robwlakes/ArduinoWeatherOS/images/DualTrace.png

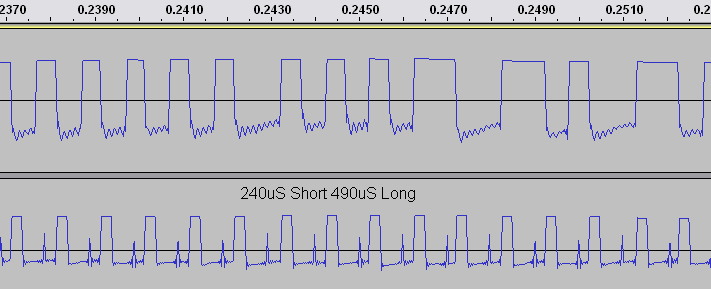
images/DualTrace.png
