robwlakes/ArduinoWeatherOS/(threads)

Thread 3 (2015-01-08):

Where is write CSV file ?

deennoo, 2015-01-08:
Hello Rob,

Nice Work You done !

I put your soft on my arduino, and a 433 recivere and my led on pin13.

I can saw my led blinking, and i think recieving my sensor information (i test osv3 sketch and it works).

Nowhere on your sketch i can see where is write the CSV file. please can you help ?

Thankyou

robwlakes, 2015-01-08:
Hi Deennoo,
The Arduino IDE has an icon in the top right hand corner that opens up a
"terminal" window to listens to the Arduino's output. I run mine at
115420 so you should set you Arduino IDE to the same Baud otherwise you
won't see much.
Also the last program that puts out the Wind, Temp and Rain on a CSV
string to the terminal (It does not write a file to the filing system as
such) waits until it has heard from all three sensors before it puts out
the CSV string to the terminal, so it may take a while, but usually
about a minute if they are close and signal is good.  If you watch the
Serial LED's (close to the Uno's pin13 LED) then you should see the
Serial Out flashing indicating that it is sending CSV strings of data
out the Uno's serial port.  It just depends on what is hooked up to that
serial port as to when, and how, those CSV style strings of characters
are seen (later processed, eg I use a Python program to listen to and
process the strings).

Just check your BAUD rate on your IDE, select the terminal window, and
wait maybe 2-3minutes at least before trying something else. I recommend
you get the simpler versions going first to just get a feel for how
everything works.  They start up straight away.

Good to hear from you,

*Rob Ward*
Lake Tyers Beach, 3909
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

deennoo, 2015-01-08:
OK i understand, first i'll wait to get some writting on serial monitor to be sure to recieve m'y sensor.

Can you share your python script ?  I want to update my Wu station with my sensor, with our exemple and anotherone (RTL_osv21) i think i'll get some succes

robwlakes, 2015-01-09:
I would be happy to but it is has been not prepared for distribution,
unlike my Arduino material.

I can certainly give you enough to get you going.

However let's get some good data off the Oregon sensors and Arduino first.

PS have you added the Air Pressure sensor and Humidity sensor?

*Rob Ward*
Lake Tyers Beach, 3909
Lake Tyers Beach Website <http://www.laketyersbeach.net.au>
XP to XUbuntu - The journey, join me!
<http://www.laketyersbeach.net.au/XP2XU.html>

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

deennoo, 2015-01-09:
Rob I dont had pressur And hum sensor on my arduino, m'y goal is to record log from all m'y osv3 sensor to update my WU station and my domoticz devices.For pressure i use a bthgn129 sensor who is osv2 And already add to RTL_osv21 by my selfEnvoyé depuis mon mobile Huawei-------- Message original --------Objet : Re: [ArduinoWeatherOS] Where is write CSV file ? (#3)De : Rob Ward À : robwlakes/ArduinoWeatherOS Cc : deennoo I would be happy to but it is has been not prepared for distribution,
unlike my Arduino material.

I can certainly give you enough to get you going.

However let's get some good data off the Oregon sensors and Arduino first.

PS have you added the Air Pressure sensor and Humidity sensor?

*Rob Ward*
Lake Tyers Beach, 3909
Lake Tyers Beach Website <http://www.laketyersbeach.net.au>
XP to XUbuntu - The journey, join me!
<http://www.laketyersbeach.net.au/XP2XU.html>

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

—Reply to this email directly or view it on GitHub.

robwlakes, 2015-01-09:
Not quite sure Deennoo what you are wanting to do.

My system at best just presents OS V3 sensors in human readable form, it
does not interface with  WWW weather services eg www.wunderground.com
etc though I am sure that could be written by people better skilled than
me.  However as it is now the software just does a simple, basic output
of data.

I am not sure what you mean here "WU station and my domoticz devices"
and "already add to RTL_osv21 by my self"

Pardon me for asking, I suspect English is not your native language?
This does not worry me, and I do not want to offend you, but I am not
fluent any other language, so if you have two languages you are doing
much better than me :-)

If you can give me a longer explanation of what you want to do I may be
able to help,

Best wishes...

*Rob Ward*
Lake Tyers Beach, 3909

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

robwlakes, 2015-01-09:
Hi Deennoo,

Sorry I have been reading and replying on email, and today I have looked on GIT-Hub for the conversation for the first time and seen all of your reply.
Your question about the "Does external sensor are needed to get value on serial monitor ?" was missing from the email.
Answer: In the last most complicated version of the program it uses two sensors connected to the Ardunio Uno board, however it does not wait for them to respond, it only waits until it has read all three wireless transmitters, Wind, Temperature and Rain.  If you don't have all three of these OS V3.0 sensors then it will wait for ever.
However the program usually crashes if the Pressure and Humidity sensors are not also there as it tries to read them and the library replies "Device not found" or some such warning.  I would suggest strongly to start from the simplest program and work your way up.  The simplest just prints out the raw codes coming in from the OS V3.0 wireless based sensors and does no processing on them (just the hexadecimal readings of the packet are shown) and does not refer to the Humidity or Pressure sensor at all so will not crash if you don't have them installed and also will not crash if you only have one OS sensor eg Rainfall.
Let me know if you can get some of the simpler versions working and how far you can get with them before things stop working.

Cheers, Rob

Here is the full circuit for the last program.
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
and it looks like this..
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

deennoo, 2015-01-10:
Rob,

what do you call simpler version ?

I got 3 .ino files
 - Debug_Auto
 - DebugManchester
 - Arduino_OsWeatherv26

What i want ? create a csv file who log my osv3 sensor

on Arduino_Osweatherv26
I try to remove BMP05 and DHT22 from your sketch, and update line 289 from 7 to 4 (by just keeping os sensor information) but result for the moment is still the same.

Does on serial monitor i can see some result of what your sketch recieve ?

robwlakes, 2015-01-10:
Sorry Deennoo,
Try the files here https://github.com/robwlakes/Weather-Station-OS-Sensors
These are my more up to date versions.
So try in this order:
DebugVersion12 Best Raw
DebugVersion12 BestDebugger

AlI apologise I did not realise you might have been in that repository. I hope you find these files more helpful.  The algorithm for Manchester decoding is so much better!

Cheers, Rob

deennoo, 2015-01-10:
ok thank you for last update, see you here !

Thread 4 (2017-02-10):

433Mhz Receiver

afeno, 2017-02-10:
Hello,
This is an excellent project and perfectly documented :)
I'm very excited to try to replicate what you have accomplished!
My main doubt is regarding the **433Mhz  Receiver board** that I should use. What 433Mhz Receiver board do you recommend?
I saw some basic and cheap boards but those looks different than the one that you have in the picture.
Example: https://www.aliexpress.com/item/Free-Shopping-433M-315M-2pair-4PCS-superregenerative-module-wireless-transmitter-module-RF-wireless-receiver-module/1850319332.html

Where can I buy the board that you used? Can you point me to some links on Aliexpress, DX, or eBay?

Thank you.
Best Regards,
Alfredo.

robwlakes, 2017-02-10:
Hi Alfredo,

I am very pleased you like the project.  I put a lot of work into the
documentation to "proof" it and try to discover and correct any errors
by doing so.  Plus a lot of other publications about Manchester encoding
and decoding were of very little help to my way of thinking.

You will find nearly any of those 433MHz Rx/Tx combinations will be ok
(as in your link).  Where the more expensive versions are better
includes-  they have a stronger rejection of noise (ie better filtered
out input), more stability, and also quicker Automatic Gain Control,
which stabilizes them onto the incoming digital modulation quicker.

Have a look at this one
http://www.ebay.com.au/itm/433Mhz-Superheterodyne-3400-RF-Transmitter-Receiver-kit-for-Arduino-ARM-MCU-/381196613735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

You will note that it does not have any coils or trimmer capacitors to
be seen which means the whole stability is in the chips on the board.

This is another brand, that is also a quality brand, Dorji,
https://wiltronics.com.au/product/7612/dorji-433mhz-107dbm-ask-receiver-dip-package/
If you are after a quality module then these Dorji receivers are
excellent if you want a better stability and more sensitive response.

The boards come in all shapes and sizes and are all pretty good, though
as I have outlined above, some are better than others.  If you intend to
use the system in a demanding environment eg noisy, long distance and/or
high temperature range (eg outside) then get a more expensive version.
My receiver is indoors and the transmitters are within 10m of the
transmitter, so the simpler cheap Rx works ok for me.  I made the board
up about 7 years ago before the better Rx's became more common. I would
choose a better Rx now if I needed to rebuild it.

I hope that helps,

Good luck and Cheers, Rob

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

--

*Rob Ward*
Lake Tyers Beach, 3909
Lake Tyers Beach Website <http://www.laketyersbeach.net.au>
Ubuntu Mate - A great OS <https://ubuntu-mate.org/>

afeno, 2017-02-11:
Thank you for the clarification and explanation about the differences between cheap and better receivers.
I bought the first one that you recommended because I can't find the Dorji's here in Spain.
I will keep you informed about my try to replicate what you did.
Thank you again for all your research and development!
Best Regards,
Alfredo.

Thread 5 (2017-02-12):

Rain calculation

Hserfontein, 2017-02-12:
Hi Rob,
I agree with afeno, this is an excellent project and perfectly documented :)
I would like to add my experience to your project. I did some vigorous testing on the rain calculation and found that a factor of "*25.4/1000.0" (instead of 25.0), yields a 100% accurate result compared to the Oregon base station.
The calculations should therefor read as follows:

void rain(){
  rainTotal = float(((nyb(18)*100000)+(nyb(17)*10000)+(nyb(16)*1000)+(nyb(15)*100)+(nyb(14)*10)+nyb(13))*25.4/1000.0);
  //Serial.println((nyb(18)*100000)+(nyb(17)*10000)+(nyb(16)*1000)+(nyb(15)*100)+(nyb(14)*10)+nyb(13),DEC);
  rainRate = float(((nyb(8)*10000)+(nyb(9)*1000)+(nyb(10)*100)+(nyb(11)*10)+nyb(12))*25.4/1000.0);
  //Serial.println((nyb(8)*10000)+(nyb(9)*1000)+(nyb(10)*100)+(nyb(11)*10)+nyb(12),DEC);

I am not sure, but I think it has to do with the fact that there are 25.4 mm in an inch.

Regards,
Hennie

robwlakes, 2017-02-12:
Thanks Hennie,

I am happy to add in your refinement.  I am about to add in the latest
version that also has the UV detector incorporated.  So I will update
the rainfall conversion factor at that time and give you due
acknowledgement.  The new version also incorporates an RGB LED that
signals with a colour as each sensor is successfully logged.  I don't
have the circuit diagram drawn yet to accompany it so it may be a little
while before the whole thing is updated.

I am pleased with your interest in the project and assistance,

Rob

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

--

*Rob Ward*
Lake Tyers Beach, 3909
Lake Tyers Beach Website <http://www.laketyersbeach.net.au>
Ubuntu Mate - A great OS <https://ubuntu-mate.org/>

Hserfontein, 2017-02-14:
Hi Rob,

I plan to add a hardware real time clock and SD card interface to mine to add a time stamp and store the data on the SD card, to make it standalone. I do not want to keep a computer running 24/7 just to record my weather data. Currently I am using CoolTerm to capture and store the data from the USB interface.

Looking forward to any new devlopments from your side.

Kind Regards

Hennie Serfontein (Snr)

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

Thread 6 (2017-03-20):

battery level

micg77, 2017-03-20:
Hello,
thanks a lot for your program.
I have found where the battery level is fixed : it is the 3rd bite of nyble 8.
If you add  battery_level = bitRead(nyb(8),2); you get it.

Hope it will help.

Micg77

robwlakes, 2017-03-20:
Hi Micg77,

Thank you for your interest in my work.  I spent a fair bit of time
trying to find a battery status bit, but could not confidently establish
anything I was confident in.  The very low current draw of these sensors
mean they approach the thermodynamic optimum to extract every last drop
from the battery (ie very little energy wasted as heat within the
battery due to its own internal resistance, which becomes more
significant the heavier the current).  As you will be aware I gave up
and devised a check on the consistency with the signals are received as
the indicator of battery health.  This also checks the actual state of
the sensor as well, ie has it fallen off the roof and lying at the
bottom of the garden???

You have also sent me another email regarding the negative bit on the
temperature sensor.  This one worries me more as people who are unlucky
enough to have to endure very cold temperatures maybe relying on that
data.  However I live in a climate that hardly ever reaches 2-3 degrees
Celsius let alone, negative Celsius.  We occasionally get frosts.  I
will definitely look into that myself.

You quote the model number of the Oregon Sensor for the thgr810
(humidity and temperature sensor using Oregon v3 protocol), was that the
one that you found the low battery bit as well?   I now have four
sensors stations: wind speed and direction, temperature and humidity,
rainfall, and have now added a UV sensor as well (3months ago).  I am
very occasionally getting some weird stuff from it though.  This morning
is an example.

SolarPower

Where you can see 5 hours ago (in total darkness) I have registered a
blip in UV Light.  I have used the standard OS checksum for the sensor
readings, so it must have complied with that to be recorded by the
Arduino.  Because I take the average of 16 readings, it is actually only
one rogue reading of 255, but this messes up the 16 subsequent readings,
hence 255/16=15, for 16 readings.  It can go for weeks before this
happens.  I am reluctant to write a crude filter, as I would prefer to
understand it and knock it out logically.  So for the moment I am
tolerating it.

If you happen to get a UV Sensor, then I would love to hear if you have
the same problem, or whether I have a faulty sensor.

Also when you were testing for the battery bit with the low temperature,
how did you eliminate the possibility that the battery low bit that
turned over did not come from erratic low voltage behaviour of the whole
system, rather than the sensor CPU deliberately switching that bit? I
found I could not be confident in the low battery indicators (that I
thought I had found) were not just random bits changing as the system
got closer to totally shut down.  Do you have an Oregon console that
receives and shows that low battery condition at the same time as you
can detect on the Arduino?  My console I keep in the kitchen does not
have any low battery indicators.  I feel that if Oregon had implemented
such a system their consoles would have shown the data on their LCDs.

Thank you for your interest and communication of your ideas.  As you can
see I retain an ongoing interest in this project and always keen to
improve it so I really appreciate your communication.  Have you
published your code anywhere?  I need to update my GitHub site very soon
so the UV stuff and LED activity indicators are revealed.

Cheers, Rob

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

--

*Rob Ward*
Lake Tyers Beach, 3909
Lake Tyers Beach Website <http://www.laketyersbeach.net.au>
Ubuntu Mate - A great OS <https://ubuntu-mate.org/>

micg77, 2017-03-21:
Hello,
thank you for your developed answer. (sorry for my level of english, I will do my best to answer you)
I don't have any UV sensor. so I can't help about your problem. But I have in mind to have one. So it is interesting for me anyway to have your feedback.

My project is not finished yet, so I haven't published anything. My goal is to control my electric heaters in each room of my house. So my arduino reads the temperature coming from 3 THGR810 sensors, and asked every electric heater to turn on or off depending on the instruction.
That is why it is important for me to have the low battery information;

I have done all my test with 3 THGR810 sensor. This kind sensor has a small screen. So i can read on it : temperature, humidity and low battery information.
So i can easily compare the screen with what tells the arduino.

I have also discover that the low battery sign turns on on the screen when the voltage is below 2,5 Volt.
To avoid rolling code problem, and minimise the number of changing value in the signal, I have build the following protocol : I have chosen 2 old AAA battery which have 2.53 Volt together at ambiant temperature (thanks to the toys of my kids). I have put the sensor in my freezer (minus -18°C) hoping that the old battery would have their voltage to decrease.
Then i have displayed all nyble waiting for any change and it has worked.
I have done many checks using this protocol.

To validate I have done some other tests with my other THGR810 sensor. And now I am really confident with my result.

Of course, I can't tell with the other kind of sensor (wind and rain).

Thanks again for your program which has helped me a lot to understand the oregon v3 protocol.

Cheers,

Micg77

robwlakes, 2017-03-21:
Hi,

My observation of the UV sensor is that it seems to reflect the "solar
power" of the day, and fluctuates largely in line with cloud cover.  So
while not being a direct solar power indicator could be used for home
control of solar heating features.  Eg opening or closing blinds etc  We
live by the sea at a popular but slightly remote beach front and people
getting exposure to UV (ie and later on cancer) is a problem so I
thought that sensor could help people be more careful.

THGR810 sensors is a good choice as think they have their station
numbers as switches?  So you can identify them.  Excellent choice.  I
have looked at those sensors in the shops but had not noticed the
battery level indicator.  I will check again for interest.  I tried to
do the low battery bit search on my anemometer as it the highest and
most dangerous to service (approx 8m high on top of steep roof).  I
could not determine any bit that changed predictably enough to be
confident of its status.  It would be good to focus though on that bit
you have identified and recheck it all over again.  I have a spare
anemometer as a backup, so I could experiment with it.  I really like
the idea of putting the batteries in the freezer to help accentuate the
"failing" battery voltages.  Excellent work!!

Replicating the same bit across three sensors is also excellent
science.  I like what you do.

I will take my anemometer to my son's place next time and experiment for
the battery bit. (Ignoring the rolling ID codes means I can't use it at
our home or it will confuse the Weather station Arduino.)  You have
inspired me to give it one more try.

Thank you, Micg77.

Rob

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

--

*Rob Ward*
Lake Tyers Beach, 3909
Lake Tyers Beach Website <http://www.laketyersbeach.net.au>
Ubuntu Mate - A great OS <https://ubuntu-mate.org/>

Thread 7 (2017-03-20):

negative temperature - THGR810

micg77, 2017-03-20:
Hello,

I've done some test with thgr810 (humidity and temperature sensor using oregon v3 protocol) that i've put in my freezer (in order to reach the low battery level).
With this sensor the nyb(12) is changed at 8 and not 1 when temperature goes below 0.
may be it depends on the kind of sensor.
Best regards,
Micg77

Saphareas, 2017-12-08:
How did you even get this working? I get nothing with this Sensor (only one I've tested).

robwlakes, 2018-01-13:
Did you get yours working? I have added Darko's code for decoding negative temperature. I don't live in a climate where outside temperature drops below zero (all year), so I was not alerted myself to this problem.

Thread 8 (2020-06-08):

Anenometer only

pdbayes, 2020-06-08:
Hi

Excellent well documented project. I only have the anenometer and want to capture the data from that. I cannot seem to get any serial data from it using your code except for the initial output. Were would I need to remove code to only collect data from the anenometer.

Thanks

Paul

robwlakes, 2020-06-11:
H i Paul,

Apologies for the delay in answering this. I am going to assume you are
trying to use ArduinoWeatherOS
<https://github.com/robwlakes/ArduinoWeatherOS>. It is set up to use
multiple sensors and and to block any reporting until all the sensors
have been "heard" and sensible data collected from them. If you are only
after the wind data you will be able to cut a lot out of the program.
Check the lines in Red here, they do the blocking until all 3 main
sensors have been heard.

   // Stn Id, Packet Type, Wind Quadrant, Wind Speed, Rain Tips, Ext
temp, Int Temp, Int Pressure, Int Humidity
   intHumi = (double)dht.readHumidity();      //DHT22 readings %Humidity
   intTemp = (double)bmp.readTemperature();   //internal temperature
   intPres = (double)bmp.readPressure() / 100.0; //Pa reduced to mBar
*//leave this check at 7 until the other readings are stabilized**
**  if ((scan&7)==7) {               //scan==15 means all 4 readings now
have a valid value, ready for output on Serial**
*    //Battery/Signal status, OR in the the four status values for the
signal connections.
     logTemp++;
     if (logTemp>40){
       batStat = batStat | 1;
       }
     logWind++;
     if (logWind>40){
       batStat = batStat | 2;
       }
     logRain++;
     if (logRain>40){
       batStat = batStat | 4;
       }
     logUV++;
     if (logUV>40){
       batStat = batStat | 8;
       }
     logExp++;
     if (logExp>40){
       batStat = batStat | 16;
       }
     //reset the batStat to 0 every 24hours
     aday++;
     if (aday>1440){
       batStat=0;
       aday=0;
       }
     // Order: Battery Status, Quadrant, Wind Gust, Rainfall,
Temperature, InternalTemp, Internal Pressure, Int Humidity, Solar Power,
Lightning, UV Radiation
     Serial.print(batStat,DEC);       //Send out the number to indicate
if a sensor is not transmitting for maore than 20 mins. Low Battery or
other damage.
     Serial.print(",");
     Serial.print(quadrant);          //0-15 in 22.5 degrees steps clockwise
     Serial.print(",");
     Serial.print(gustWindspeed, 1);  //Gust windspeed km/hr, not
average windspeed (graphing over 10 samples gives Average)
     Serial.print(",");
     gustWindspeed = avWindspeed;     //reset gust to average, then take
the larger next reading
     Serial.print(rainTotal, 1);      //currently considered to checked
for a good calibration to mm
     Serial.print(",");
     Serial.print(temperature, 2);    // OS Temperature Centigrade
     Serial.print(",");
     Serial.print(intTemp, 2);        //BMP085 temperature (used for
compensation reading) Centigrade
     Serial.print(",");
     Serial.print(intPres, 2);        //BMP085 pressure reading milli-bars
     Serial.print(",");
     Serial.print(intHumi);           //Digital DHT22 seems better than
the OS in Temp/Hum sensor % relative
     Serial.print(",");
     Serial.print(intSolar,DEC);       //A reading from experimental
Solar Power sensor
     Serial.print(",");
     Serial.print(intLightning,DEC);       //A reading from the nos of
Lightning Strikes
     Serial.print(",");
     Serial.print(intUV, DEC);      //UV Sensor
     Serial.println();

     //Indicate the transmission of this one second data with a white
light set up R+B+G!!
     digitalWrite(RedPin, 0);         //White, all colours on, data has
been logged to the Server
     digitalWrite(GrePin, 0);
     digitalWrite(BluPin, 0);
*}*
}

If you remove that IF clause then it should at least begin reporting
your wind data and just the initialising defaults for the other sensors.

Once you have that working you can owrk backwards to trim the program
back to what you need for your project.

Thank you for taking an interest in my project and communicating with me
about it.

Best wishes,

Rob

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
--

*Rob Ward*
Lake Tyers Beach, 3909
Lake Tyers Beach Website <http://www.laketyersbeach.net.au>
Ubuntu Mate - A great OS <https://ubuntu-mate.org/>

pdbayes, 2020-06-12:
Hi Rob

Thanks for getting back to me. I tried removing the If statement but I am
not having much success. I put in a load of debugging and thought I could
see 5 byte packets from the anemometer, but nothing ever gets analysed and
output.
I am now running your auto debug code to see what I get. I'll share a dump
of the output later to see if you can make any sense of it.
I am using an Arduino uno and an RXB6 receiver.
Thanks again for all the work you have put in to this.

Paul

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

pdbayes, 2020-06-12:
i think I also have an issue that we have 433mhz oil tank level sensors. If
the signal from them is strong then the AGC is doing to crank down the
sensitivity and miss the Oregon bursts. Not sure how to deal with that.

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

robwlakes, 2020-06-12:
The wind sensor repeats about every 14 seconds, so it should be able to get at least one burst in every now and then.

Are you sure your receiver is wired up ok? If you put an LED + 220ohm resistor on the Tx output, and press reset on the wind sensor it should show z distinct burst of signal on the Rx straight away. Quite a few people who gave contacted me have found their Rx is the fault. I looked up your Rx and it looks very good quality. Maybe even your antenna needs checking, a simple whip of 170mm hook up wire is ok, especially at small distances.

Legally 433Mhz signals should only broadcast intermittent bursts. So the tank system should not swamp your Rx continually.

Rob

Cheers, RobW

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

pdbayes, 2020-06-12:
Thanks again

I'm sure it is recieving data from somewhere as I do get consistent 5byte
blobs of data. I have found the info for decoding the depth sensor so I can
see if I am picking that up. Might be useful to have anyway. I get an I'd
of 1985 a lot. I thought the anenometer was either 1995 or 1994?

I can send a dump from the debug if you have time to take a look.

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

Thread 9 (2020-08-28):

WGR800 error - wind speeds >10m/s

jrhilton, 2020-08-28:
Hi, I've noted that wind speed never goes above 36km/h (10m/s) yet when I look on the OS consol during high winds it does.

The speeds match up exactly to the consol otherwise, except during very high winds. What could be causing this issue?

Almost as if it should be something like this to also get the tens, as I can see it gets the ones, and decimal tenths:
`double gust = (**(nyb(14) * 100) +** (nyb(13) * 10) + nyb(12)) * 3.6 / 10;`

and
`avWindspeed = (**(nyb(17) * 100) +** (nyb(16) * 10) + nyb(15)) * 3.6 / 10;`

Not had a chance to upload this to try, but has anyone else noticed this issue?

robwlakes, 2020-08-29:
Now that is very interesting James, I have had similar suspicions. Not
the least of which occurred this last Thursday night when there was big
wind storms across the state and we copped a bit of it too. It felt like
it was about to take the solar panels off the roof. Yet the wind speed
30+ something did not seem to reflect the feeling I had that it was
exceptional. I will check the code I am using at the moment and try your
suggestion.  I have wanted to update this code for ages but GITHub I
find incredibly frustrating and not for beginners like me. I seems to
tie myself in knots just to get an update to work (entirely due to my
ignorance I am sure).

Thank you for interest and analytical thinking about this. I will get
back to you.

Rob

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
--

*Rob Ward*
Lake Tyers Beach, 3909
Lake Tyers Beach Website <http://www.laketyersbeach.net.au>
Ubuntu Mate - A great OS <https://ubuntu-mate.org/>

jrhilton, 2020-08-29:
Hi Rob, many thanks for your reply. I've had another read of [http://wmrx00.sourceforge.net/Arduino/OregonScientific-RF-Protocols.pdf](this) document that details the RF Protocols and it does spec three nibbles making up the speeds, so adds some substance to my logic. The numbering of the nibbles is slightly offset in that document vs your code, but if you normalise them using the wind direction nibbles then there is a perfect overlap when you add in nyb(14) and nyb(17) to your code.

I've now added this code:

`gustActualMS_tst = ((nyb(14) * 100) +(nyb(13) * 10) + nyb(12)); //new test
avWindspeedMS_tst = ((nyb(17) * 100) + (nyb(16) * 10) + nyb(15));//new test`

Which are also sent via the serial port using dumpAnemom() and logged. I may need someone else to help validate this too as wind speeds >10m/s are rare here in London, UK. So it maybe many months before I get some actual data to validate it myself, but I will be sure to report back when I do have some data.

Stay safe and well in these times!

robwlakes, 2020-08-30:
Hi David,

I ignored my own notes from about 10 lines up. Thank you for your
diligence, I have altered the source code and hope to update it on
GITHub ASAP. I have added an acknowledgment for your contribution.

Like you, we don't often experience over 36m/s winds, even though we are
on the southern east coast of mainland Australia. We are only 10minutes
walk form the ocean. However we are at the top of a very wide bay and
don't really get the feel of the roaring fourties. So it maybe a while
before we can see any difference. I have an updated version of the
Manchester algorithm that I will incorporate when I update. It is much
more elegant than in the current version. Same concept but not as
convoluted.

I think what we would have seen with the MSB missing would have been
chopped wind speeds reported when the reading was above 36km, LSB's 
would have dropped to "low" and the MSB would have been absent to take
over. I feel I have noticed that before and just put it down to gusty
conditions, ie peaks and troughs. Whereas it could have been hovering
above and below 36m/s consistently, and the dips coming from the lack of
MSB input. My Web site wind graphic uses an 8 samples rolling average so
indicates "8x1 minutes"  so that would tend to hide the extremes as
well. It may well be that which has dulled my observations. I do keep a
"peak gust" recorded over the last hour, so that should show it. I will
need to look for above 36km :-)

Thanks again, Rob.

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
--

*Rob Ward*
Lake Tyers Beach, 3909
Lake Tyers Beach Website <http://www.laketyersbeach.net.au>
Ubuntu Mate - A great OS <https://ubuntu-mate.org/>

jrhilton, 2020-09-06:
Thanks Rob, as an update still no high winds here, plenty of sunshine instead so we shouldn't complain!

So not got a chance to test the changes at this end yet. Though as a side note I have ported the code over to run on an ESP8266 which interestingly when using the same type of receiver module and stock antenna is far more sensitive and picks up all transmissions even on the other side of the house where the Arduino plus the same receiver module would be deaf. And that is with the receiver running at 3.3v instead of 5v. Either i've got super lucky with a very sensitive receiver module when running at 3.3v or the ESP8266 has much better timings (which I suspect is the case).

Kind regards,
James

robwlakes, 2020-09-06:
Now that is very interesting. My wind sensor is on the very top of the gable of our roof. Our house is a two story "upside down house" and the weather computer gear is in the garage below at ground level. The wind Tx is above a galvanised iron roof and it has always been the trickiest to detect, the first to dropout. Your message is timely indeed. I had to get up on the roof (not recommended for anyone over 60) yesterday and put some new lithium Alkaline AA batteries in the Tx to get from about very marginal 40% reception success to around 95% success. The standard Alkaline AAs I removed were still in good condition, but obviously not good enough.

I have suspected that the RF environment on a Standard Uno board may generate hash that dulls the sensitivity of the 433MHz Rx. Not being versed many of the black arts of RF means my experiments this time (last week) was limited to putting the Rx supply wire through a few turns  of a small toroid and putting a 0,4uf ceramic on the power supply of my 433MHz test rig. I did not get any where near your improvement, hence dragging out the fresh batteries.

I have a spare ESP8266 I could try. I might also try the Rx on an "umbilical" leads to  just physically seperate it from the Uno. I am definitely not returning to the roof to put the marginal batteries in. Haha.

I am almost ready to publish the new Manchester algorithm (same idea with delays, but much cleaner code) so I am hoping you might be willing to give me some early feedback. Some more information on your ESP8266 work, (a link maybe?) would be extremely interesting.

Thanks for your interest and feedback.
Rob

Cheers, RobW

roberto1984, 2020-11-21:
Hi all guys, hi Rob!
i'm also using the esp8266 since 1 year ,starting from rob code that i have adapted for esp8266 nodemcu, uploading every 50 seconds to a mysql database.
I also confirm that the wind was "capped" at 10m/s, just today i added the fix from jrhuilton(thank you!!!!),i will let you know if the reading between console and nodemcu are aligned!

Cheers!
Roberto

jrhilton, 2020-12-28:
hello @robwlakes / @roberto1984 -  I hope you are both keeping well and safe! Sorry for such a delayed update but this week we had the first winds >10m/s since my last post. As a result of Storm Bella I recorded a max of 59.76 m/s on 27th December from one transmission which the console didn't record (not surprising as I note it doesn't register every transmission anyway). However it shows a max of 49.6km/h which I have correlated to the data in my SQL database for the same time. So I am satisfied that my code suggestion works and is matching to the console.

Thread 10 (2024-11-21):

we face  Arduino uno R3 code issue

amirfoysol, 2024-11-21:
we bought this item for our weather station project :
Bread Board

I2C display

10k Resistor

DHT111

BMP180

Rain Sensor

433MHz RF transmitter module

Buck  converter

anemometer

I need Arduino uno r3 code to run this project

robwlakes, 2024-11-21:
Hi,
Can you send me the details of the anemometer and rainfall pls so I can check what you are working with.
Cheers, Rob

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

robwlakes, 2024-11-21:
Hi, the sensors you have chosen ate not suitable for my software. First the anemometer is analogue voltage output, whereas my system works with a digital 433Mhz signal. The rain detector you bougt is literally that, it will detect rain on or off, but will not measure rainfall in cm3 and is also direct connect not digital 433Mhz.
The picture below is the Oregon Weather Station my my software interacts with. Unless you have these sensors my system is of no use to you.
Sorry to be the bearer of bad news.
Put into Google the code number and "Arduino" to see if it will find a suitable project to help you.

Cheers, Rob.

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

amirfoysol, 2024-11-22:
I need your help .Can you provide me code based on my equipment list  . I'm stuck with my project for accurate code.

robwlakes, 2024-11-22:
How good are you with Arduino IDE and the basics of the C language? If you are just starting out, have a look at the Arduino examples in the IDE and build on them. I don't even know what the overall objective is? Building a weather station is not enough information for me. What are you going to use it for? How accurate does it need to be? etc etc.

Try some examples before you get back to me pls.

Rob

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

amirfoysol, 2024-11-22:
Sorry for wasting your valuable time. Basically I'm trying to build a water station project. But I don't have enough knowledge about programming languages . At this point I face some difficulties .

robwlakes, 2024-11-22:
That is OK, you have some interesting gear to work with. Do the rain detector first  (anemometer second and the screen last, it wil be the hardest). Just print results to the Serial display (part of the UDE) first. Maybe find some Youtube videos on Arduino IDE??

Play around with the Arduino IDE examples to get some experience.
Best wishes, Rob

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

amirfoysol, 2024-11-22:
If you don't mind can we connect through discord or any other social media id. I think I can learn many things from you .
