robwlakes/ArduinoWeatherOS/(commit log)

2014-04-17 Create Arduino_OS_WeatherV26.ino
    Arduino Uno (with a 433Mhz Rx) outputs a CSV file with data intercepted from an OS WMR86 Weather Station (Anemometer, Wind Direction, Temperature, Rainfall) plus on board digital Barometer and Humidity sensors
2014-05-23 Probably the Finished Version
    Describes the RF format, the decoding of the Manchester protocol, the packet format, and expression of the sensor parameters, check sum, and CSV ASCII Output for V3.0 Oregon Scientific Weather Sensors.
    Comments welcome...
2014-05-26 Add Photos, schematic and corrections
2014-07-27 Added General Manchester decoding program that people can play around with a handful of variables and be able to receive bytes from their transmitters eg weather sensors. It will be up to users to pr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
2014-07-28 VIP: Correcting a conditionla where header not accepted and first zero is yet to be found.
    [DebugManchester.ino]
2014-07-28 More brackets to be sure
2014-07-31 Major improvement in decoding logic, getting logic state for the data before setting up for the next bit, rather than processing it after. Much more direct and appropriate. It did work before but int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
    [DebugManchester.ino]
2014-08-01 Fixed increment of maximum timeout allowed if transition not detected soon enough. Also added a counter to monitor the number of hits for each delay setting.
    [Debug_Auto.ino]
2014-08-01 Corrected and error where the data bit is captured to stop overun errors at th eend of bytes causing the whole packet to be dumped.
    It shoudl read the last bit of the last byte without,
    what happens after that wrecking it.
    [DebugManchester.ino]
2014-08-02 Auto debug of Machester Code - Arduino Uno sample output Using Oregon Scientific weather station transmitters
2014-08-02 Forgot to make longer delay change when short delay was incremented.
    [Debug_Auto.ino]
2017-01-03 Weather station now with exerimental sensor and indicator LEDS.
2017-03-22 Aduino Oregon Scientific Weather Sensors Interceptor
    Updated the weather station to include monitoring an
    Oregon Scientific UV Detector UVN-800.
    As well the promised RGB status indicator with a different colour
    for each sensor logged, and white to signal data sent.
    The system also flags when a sensor is missed for 20 minutes
    in a row, and reset is at least 100 subsequent reads occur.
    This allows monitoring of battery status and such as things
    as antenna changes, or signal obstruction or RFI.
2017-03-22 Extra Sensor and Status indicator RGB LED
2017-03-22 Added photo of RGB Status LED
2017-03-22 Wrong Photo of RGB Status LED
2017-03-22 Added information about Status RGB LED
2017-12-24 Adding Darko corrections to Temp Decoding
    [MainWeather_09.ino]
